gbhug5a/Solar-Power-Load-Sharing/OpAmpVersion/Simulation/OpAmp-LT1494-SimulationFS.png

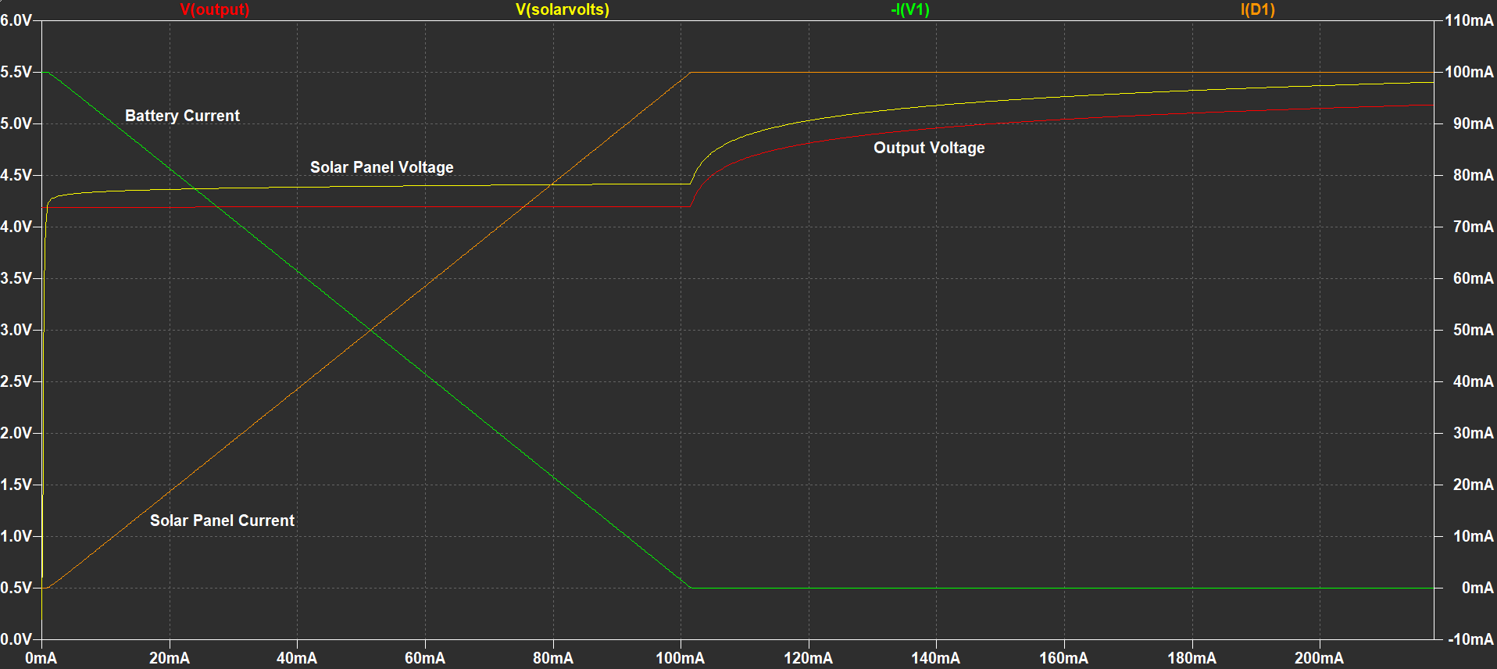
OpAmpVersion/Simulation/OpAmp-LT1494-SimulationFS.png
