gbhug5a/Solar-Power-Load-Sharing/OpAmpVersion/Solar Charger - Op Amp Version.png

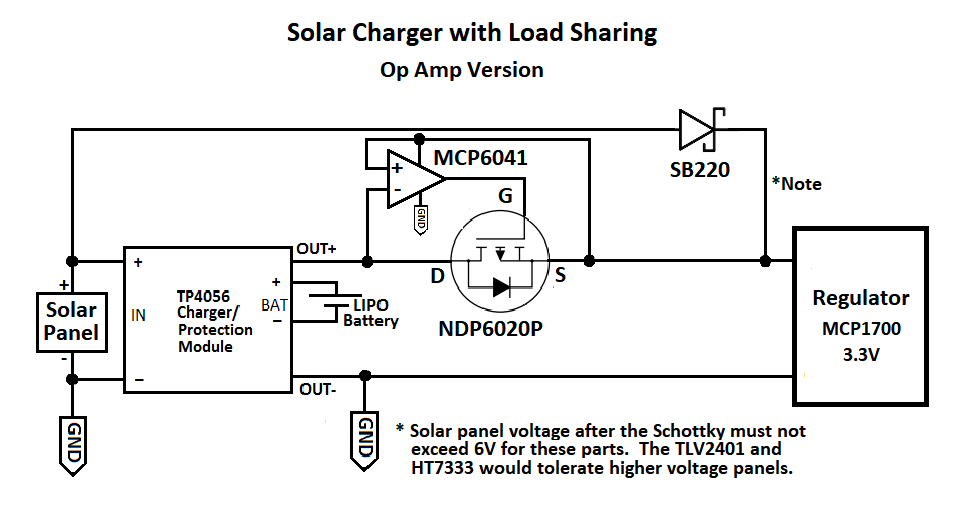
OpAmpVersion/Solar Charger - Op Amp Version.png
