gbhug5a/Solar-Power-Load-Sharing/StandardVersion/Simulations/Sim-Standard-Log.png

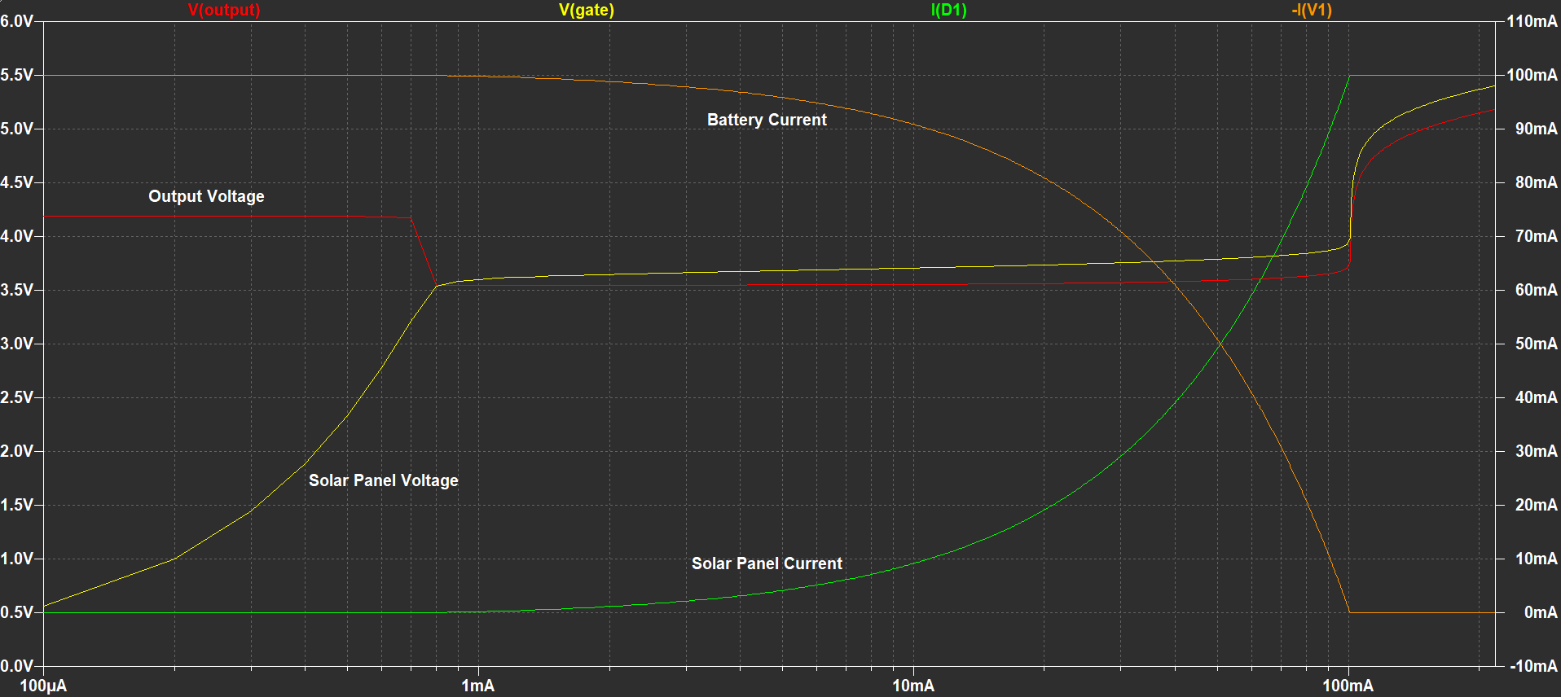
StandardVersion/Simulations/Sim-Standard-Log.png
