gbhug5a/Solar-Power-Load-Sharing/StandardVersion/Simulations/Sim-Standard.png

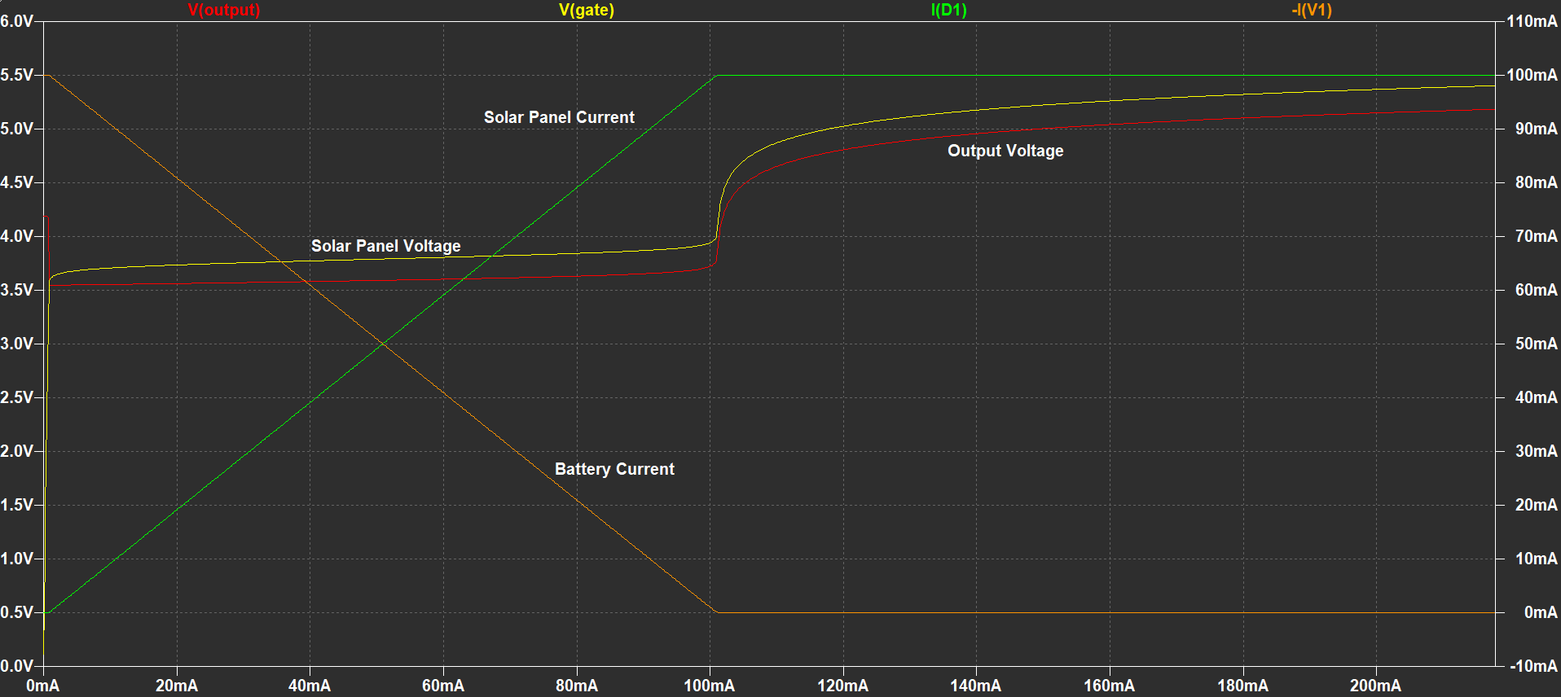
StandardVersion/Simulations/Sim-Standard.png
