gbhug5a/Solar-Power-Load-Sharing/StandardVersion/Solar Charger - Added Diode.png

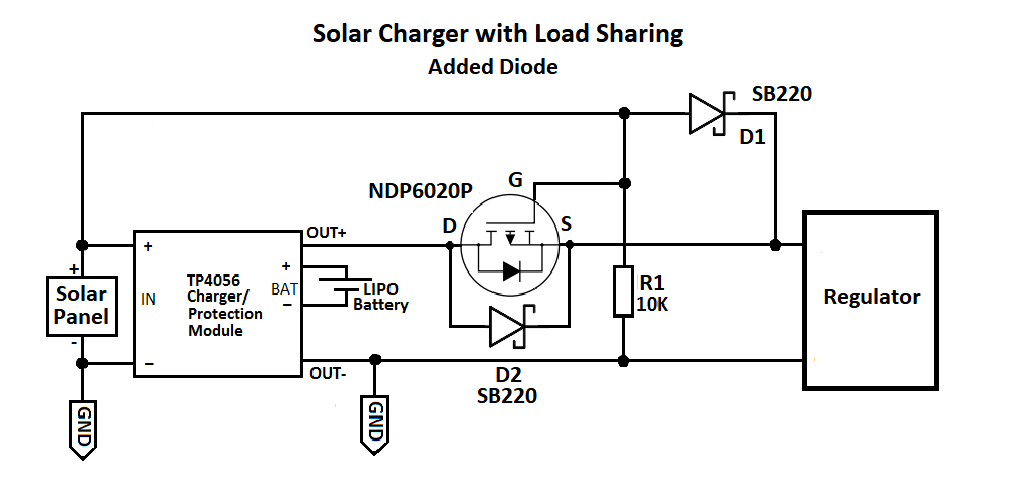
StandardVersion/Solar Charger - Added Diode.png
