gbhug5a/Solar-Power-Load-Sharing/StandardVersion/Solar Charger - Standard Version.png

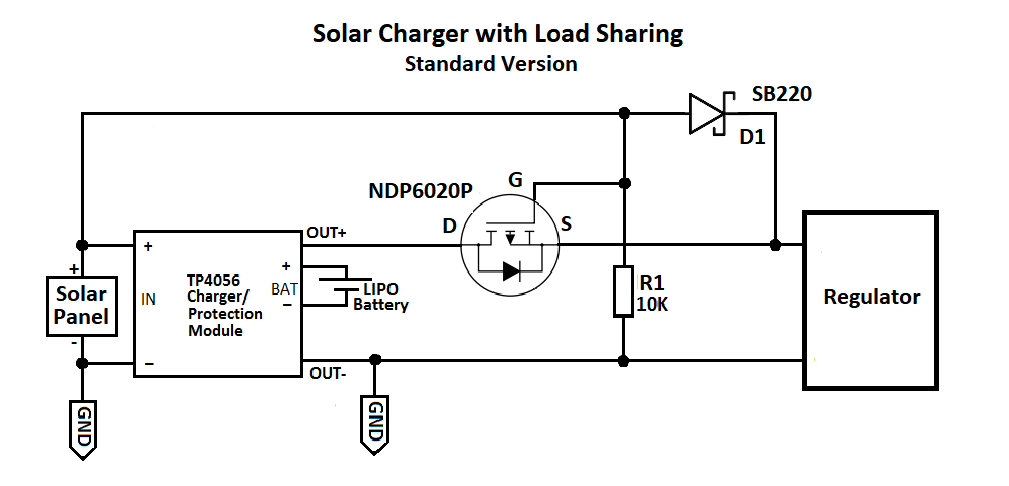
StandardVersion/Solar Charger - Standard Version.png
