gbhug5a/Solar-Power-Load-Sharing/OpAmpVersion/LTspiceFiles/OpAmp-LT1494.asc

D1: schottky; DFLS220L
I1: current; 100m; load
Isc: current; 217.8m
M1: pmos; NDP6020P
U1: LT1494
V1: voltage; 4.2; Rser=.05
X1: SolarPanel
Named nets: 0, Output, SolarVolts, Gate
.lib NDP6020P.txt
.dc Isc 0 217.8m 0.1m
Solar Panel
SM531K08L
Battery
