gbhug5a/Solar-Power-Load-Sharing/StandardVersion/LTspiceFiles/AddedDiode.asc

D1: schottky; DFLS220L
D2: schottky; DFLS220L
I1: current; 100m; load
Isc: current; 217.8m
M1: pmos; NDP6020P
R1: res; 10k
V1: voltage; 4.2; Rser=.05
X1: SolarPanel
Named nets: 0, Output, Gate
.lib NDP6020P.txt
.dc Isc 0 217.8m 0.1m
