gbhug5a/Solar-Power-Load-Sharing/(threads)

Thread 1 (2021-08-20):

questions

donbrew1, 2021-08-20:
Why not put a booster between the panel and the TP4056?  Then you would have a constant 5V into the TP4056.  If needed another booster on the output.  The boosters are almost as cheap as the TP4056.

Doesn't the added diode just bypass the p-fet?  Making the p-fet useless.

gbhug5a, 2021-09-18:
Sorry to be late responding.

I don't think a boost regulator on the input would accomplish much.  As it is, even if the solar panel can't supply enough power to turn on the TP4056, it will still contribute as much current as it can to the load at the battery voltage.  So what energy it can produce is always being used in some way.

The material here assumes a 3.3V output supply is needed, which is provided by a linear regulator.  If 5V is needed, then you would need a buck/boost converter to handle both battery voltage and panel voltage in full sun.

Adding an extra Schottky diode only bypasses the p-fet when the p-fet is off.  But at night, the p-fet is turned on, which bypasses both the body diode and the extra diode.  So in the dark there is no voltage drop across the p-fet.  But the opamp model is even better because there is never any voltage drop across the p-fet when the battery is supplying any current to the load.  The ouput voltage is never lower than the battery voltage.

gbhug5a, 2021-11-04:
Actually, the in the module its the DW01, not the tp4056, that switches the low side.  But the mosfets driven by the DW01 are always fully on unless there's an over-current or over-disharge event.  If they turn off, something has gone majorly wrong, and the battery negative terminal will be disconnected from ground.

I don't know what to suggest about your D1 problem.  I tested the two diode model and it worked fine.

Thread 2 (2023-03-02):

experiments with CN3065 charging module

morrowwm, 2023-03-02:
Inspired by the discussion over on eevblog, I tried your idea with a CN3065 based charger, [like this].  (https://www.amazon.com/Charger-Lithium-Battery-Application-Charging/dp/B07KNVBYRL).

Solar panel into CN3065, battery out and "system out" to a 2 schottky diode power path decider, which outputs to the real load, a  3.3V Arduino Pro Mini. Partial schematic attached, showing the Arduino as a load resistor.

The idea is the output of the solar panel goes straight to the load when it's high enough, so the load does not interfere with charging the battery according to the CN3065's scheme. When the panel power drops below the battery voltage, the battery takes over powering the load.

After some time, I think related to the solar panel power dropping (i.e. at night), the Arduino will go into a strange constant rebooting state. Disconnecting power gets it going OK again. Voltage as measured with a meter is fine, and the drops across D1 and D2 make sense.

I do have a 220 uF capacitor across the load's power rails, thinking that would help smooth out the transition between states. Maybe that's actually enabling some oscillation?

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

gbhug5a, 2024-11-07:
Sorry I didn't respond when you posted this.  I guess I need to check for issues more often.

I don't know what would cause the Arduino to go into a boot loop.  The schottky diode produces a 0.3V drop, but even so, the Pro Mini shouldn't drop out.  But it almost has to be something like that - some power issure that's causing a brownout.

Thread 3 (2025-07-05):

work with CN3791?

garudaonekh, 2025-07-05:
Hi,
I am using CN3791 which has mppt. Does your circuit also work? I have a complicated power demand. I use esp32+ A7670C modem which has a 2.5A current spike during its transmission.

Thanks
